raipranav384/EW2_Audio_Amp/Report_ppt/EW-2 Report.docx

EW2 Report:

Pre Amp

Gain

Filter

- Invertin
- Calcualtion

Power-Amp

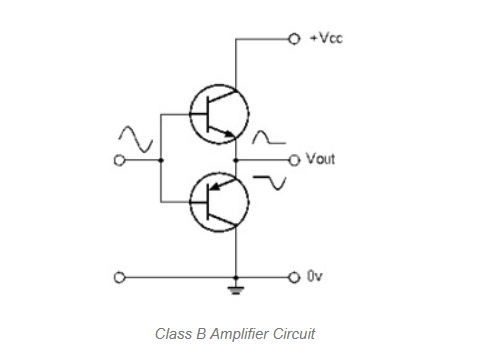
[picture p13: figure]

Mic and Speaker….
