raipranav384/EW2_Audio_Amp/Report_ppt/EW_2_report_audioAmp_2020112022_2020112019.pdf

# Audio Amplifier

EW-2

Rohan Gupta – 2020112022
Pranav Manu – 2020112019
- The goal of audio amplifiers is to reproduce input audio signals at sound-producing output elements, with desired volume and power levels—faithfully, efficiently, and at low distortion.
- Audio frequencies range from about 20 Hz to 20 kHz, So the amplifier must have good frequency response over this range (less when driving a band-limited speaker, such as a woofer or
a tweeter).
- Following are the stages of a general audio Amplifier:

Components Used:

Component Name | Values
1. Resistor | 100K, 120, 33k, 8.6k, 1MEG, 330, 4.7K, 75K, 13K, 10K, 120k
2. Capacitor | 470u, 1u, 4.7u, 100p, 1n
3. BJT’s | BC 547B, BC 557B, Tip 31C, Tip 32 C
4. Opamp | LM 741
5. Mic
6. Input Source | +-13 V

# Mic Stage

- A transducer which converts sound to voltage.
- Microphones produce very small ac signals that have to travel across long wires to the preamplifier; therefore, impedance is vital at this first stage to prevent signal loss


A Simple Mic Circuit

Mic | Pre-amp | Gain | Filter | Power- Amp

# Load

As we can see that this circuit consists of simple components like a resistor and capacitor, here resistor is used to limit current and the capacitor is responsible for amplifier gain which you can connect with this circuit to amplify the signals. This simple condenser mic circuit is to convert the acoustic sound signal into an electric audio signal.

# Pre-Amplifier Stage

- Preamplifier is a type of electronic amplifier. It doesn't have enough power to feed speakers. Rather a preamplifier amplifies weak signals, for example from a microphone, and removes noise for electronic processing or distribution.
- Preamp boosts a low-level signal, making it line level.
- A typical sensor circuit produces an output voltage between nodes A and B (see Fig. 1), where Vc is called the “common-mode” voltage and Vd the “difference-mode” or “differential” voltage. The common-mode voltage is a result of the biasing arrangement used within the sensor
- We don’t require common mode voltage, so we use differential amplifier circuit as pre-amp to amplify differential mode voltage which is the quantity of actual interest.
- The output of differential amplifier is given by:

Vout = AdVid + ACVic

- where Ad is the differential gain, and Ac is the common-mode gain. A good differential amplifier should reject Vic entirely, i.e., it should have Ac = 0. In reality, Ac for a differential amplifier is small but finite, and a figure of merit called the “Common-Mode Rejection Ratio” (CMRR) is used to indicate the effectiveness of the amplifier in rejecting common-mode inputs. The CMRR is defined as

CMRR = |

Ad
Ac

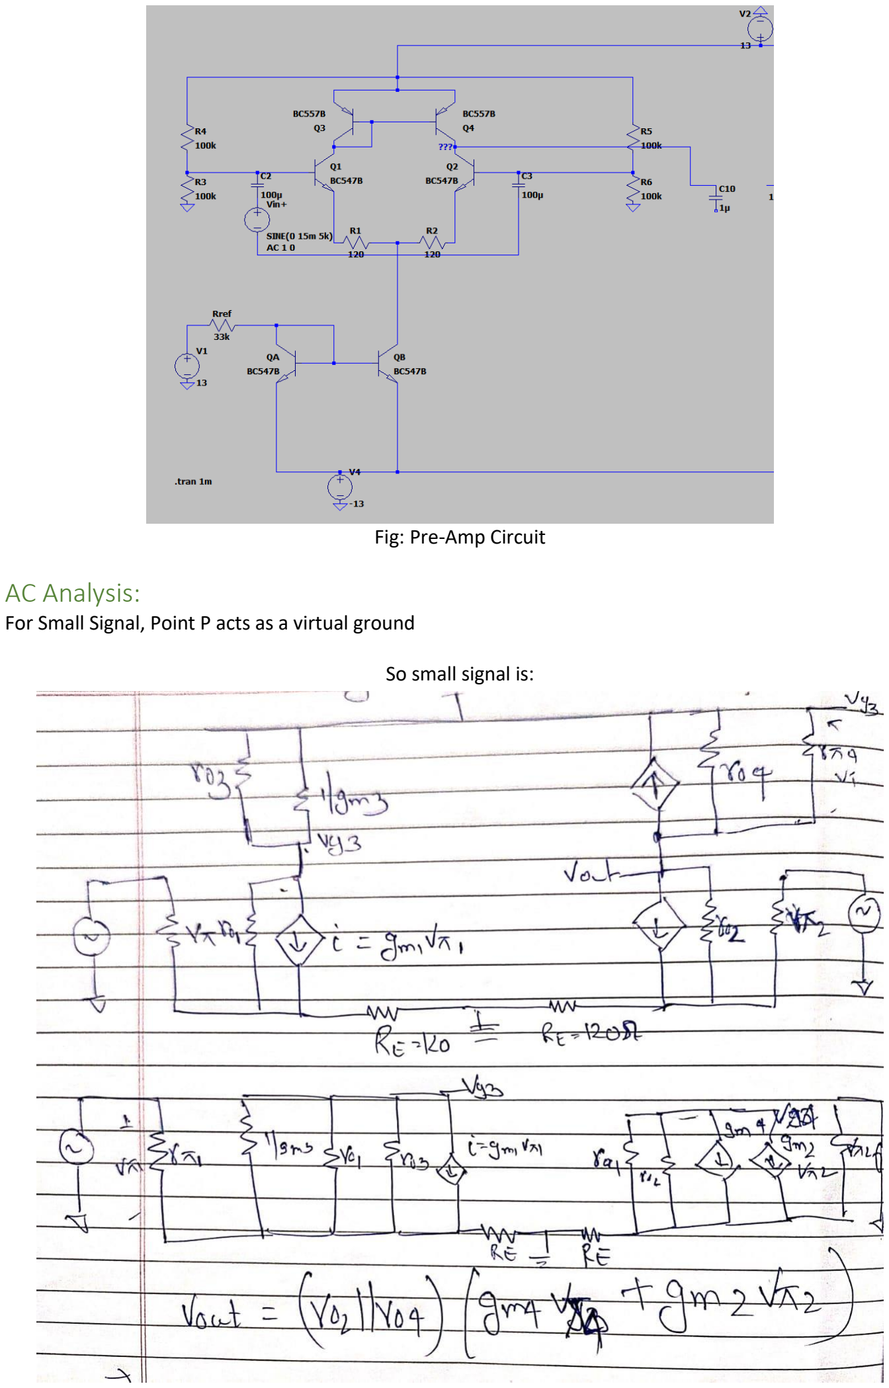
[picture p14: page 3]

Fig: Pre-Amp Circuit

## AC Analysis:

For Small Signal, Point P acts as a virtual ground

So small signal is:

Since the transistors are matched, we can say

Vout = (ro2 ∥ ro4

)(gm4vπ4 + gm2vπ2

)

From Common Emitter- Emitter bias and half circuit we can say:

Vπ =

Vin
(1 + gmRE

)

Since all the Transistors are matched and Vin =

Vid
2

Vout =

r0gmVid
4(1 + gmRE

)

, β = 327, r0 =

Va
IC

, gm =

IC
VT

=

393uA
26mV

= 0.015

Av =

20.1
1
0.015 + 120

= 237. 31

Rout = ro = 20Ω

Ideally, we want common mode gain to be zero but, that is not the case, so we calculate the ration between gain of differential input and differential output to calculate CMRR. The more the CMRR, better is the noise suppression in the differential amplifier.

Ad = 47. 02 dB
Ac = −70 dB,

∴ CMRR = 117.02

Current Mirror is used to bias the circuit.

IC =

26
2 ∗ 33k

= 393uA

Current mirror provides the desired bias current and simultaneously achieves a high CMRR.

## Simulation:

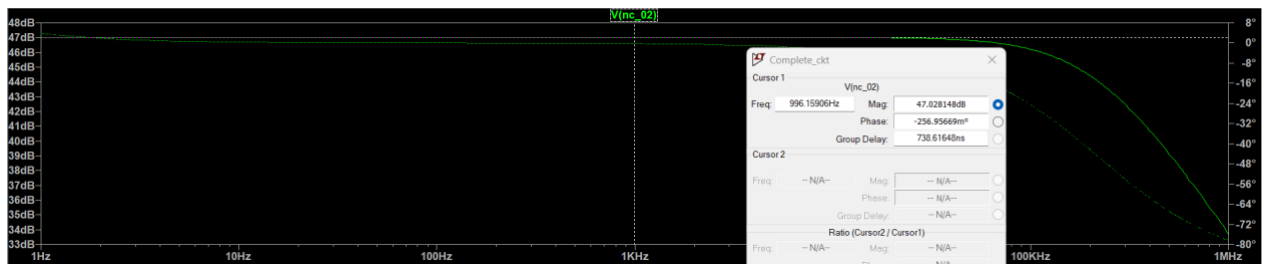
[picture p15: figure]

- The gain in simulation is 47dB, which is close to 223

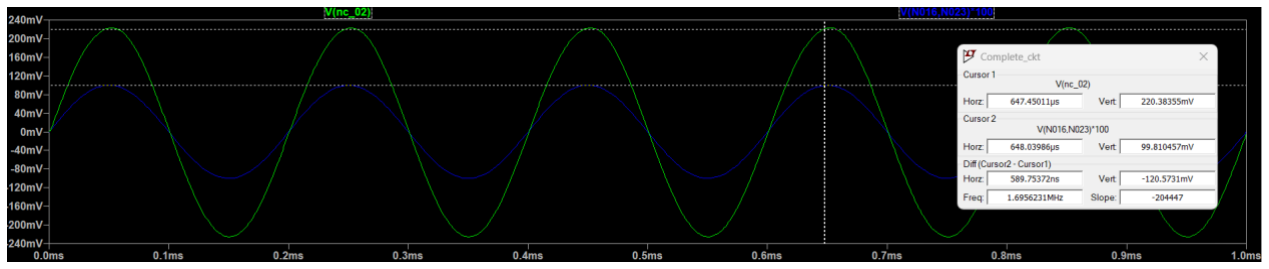
[picture p16: figure]

Gain when rest of the circuit is attached: 39.1

## Summary:

Gain | 231
Rout | 20. 1Ω

# Buffer Stage

The gain obtained in the differential amplifier stage is affected by the stages ahead, because of the changes in current drawn and reactance of further stages. To make the differential amplifier stage independent of the other stages, we can use a buffer stage, also called a Source Follower. The gain of a source follower is ideally equal to 1, and has a high input resistance, and a low output impedance (like a voltage source).

## DC Analysis:


VCC = 13V

VBE = VCC − IC ∗ RE

Assuming IB → 0, VB ≈ VCC and in forward bias of base and emitter, VBE ≈ 0.7V

IC =

VCC − VBE
RE

=

12.3
1000 = 12.3mA

## AC Analysis:

The circuit above is the source follower circuit used. Small signal model of the source follower is (Ignoring) the early effect:

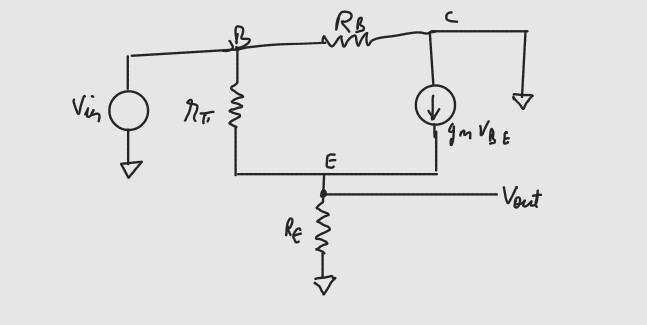
[picture p17: figure]

Gain
Therefore, gain can be derived using KCL at E:

{VBE}
{rπ

}

+ gm ∗ VBE =

Vout
RE

VBE (

1
rπ

+ gm) =

Vout
RE

VBE = Vout − Vin and gm ∗ rπ = β

Av =

RE

(1 + β)
rπ + RE

(1 + β)

Av =

RE
rπ
1 + β

+ RE

≈

RE
rπ
β

+ RE

Here, β = 327, rπ =

β
gm

, gm =

IC
VT

=

12.3mA
26mV

= 0.473

∴ rπ =

327
0.473 ≈ 691Ω

Av =

1000
691
327 + 1000

= 0.998

Av = 0. 998

Input Impedance:
Input impedance can here be similarly calculated, to get: Rin = (rπ + RE

(1 + β))||RC

Where, rπ = 691Ω,RE = 1kΩ, β = 327,gm = 0.473

Rin = 8380.7 Ω

Output Impedance:
Output impedance is calculated using: Rout =

1
gm

||RE

Rout = 2. 11 Ω

## Simulation:

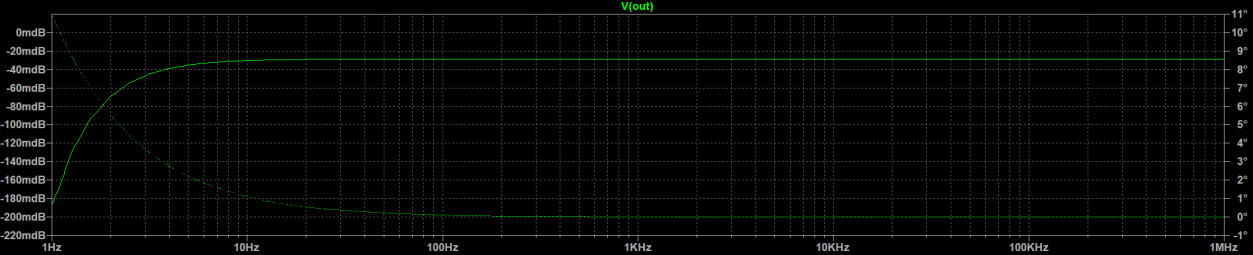
[picture p18: figure]

- The gain in simulation is -20mdB, which is close to 1

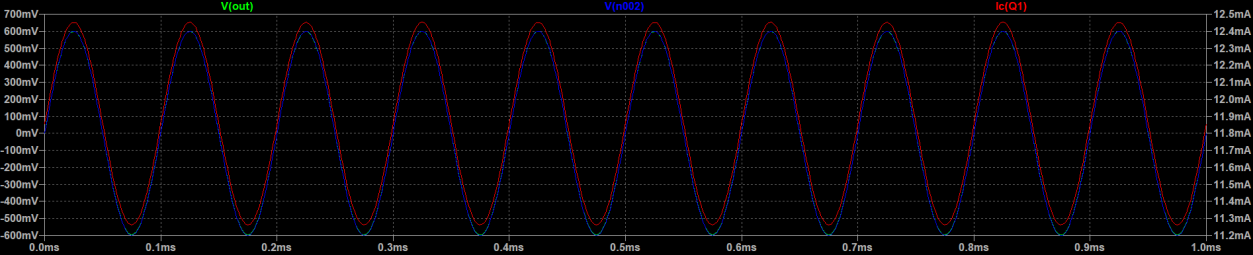
[picture p19: figure]

- The output and input coincide, and the current is centred around 12mA

## Summary

Gain | 0.998
Rin | 8. 3kΩ
Rout | 2. 11Ω

∴We see that the input impedance is high and the output impedance is small and gain is 1, so the previous stage sees this as a voltmeter, and the next stage sees this as a voltage source, and the gain of either side is unaffected.

# Gain Stage

Gain stage here is used to increase the total gain obtained to around 500. For this, we use a CE Amplifier setup, with emitter degeneration and self-biasing. The CE amplifier is simple amplifier circuit that gives voltage gain, with little to no current gain. The input is provided at the Base, and the output is taken from the Collector.

The resistor at the emitter is improves the linearity of the circuit. It also increases the input impedance, which is desirable, as explained in the buffer stage.

Self-Biasing:-

We use self-biasing to bias the CE amplifier, which provides a feed back loop, to maintain the BJT in forward active region. When Vout increases, VBE increases as VB increases, because VB ≈ VC ∵ IB ≈ 0, so IC increases, which reduces Vout = Vcc − ICRC, making a negative feed back loop.

## Circuit Diagram

## DC Analysis:


VBE = VB − ICRE + Vcc
VB ≈ VC = Vcc − ICRC
VBE ≈ 0.7V in forward active region

0.7 = 2 ∗ Vcc − IC

(RE + RC

)

IC =

25.03
12330 = 2.051mA

## AC Analysis:

Small signal model:

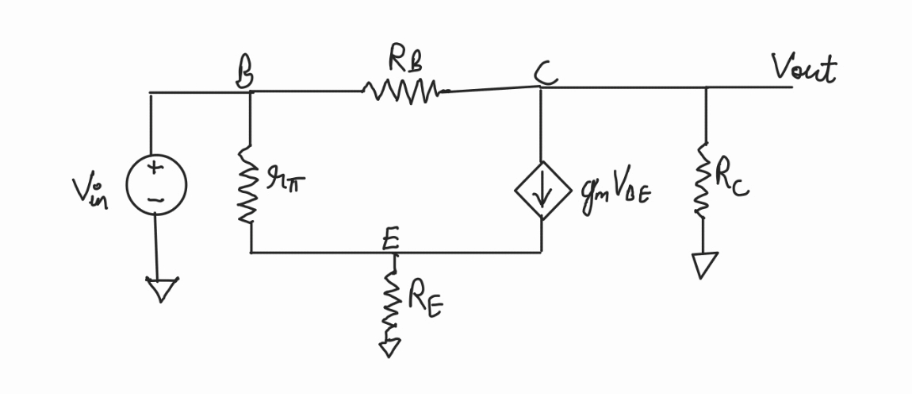
[picture p20: figure]

Gain:
KCL at C:

Vout
RC

+ gmVBE +

Vout − Vin
RB

= 0

RB = 1e6 ⇒

Vout − Vin
RB

≈ 0

VE = I ∗ RE
VE = (gmVBE +

VBE
rπ

) ∗ RE

VBE = Vin − VE

VBE =

Vin
1 + (gm +

1
rπ

) . RE

⇒

Vout

Vin

= Av = −

gmRC
1 + (gm +

1
rπ

) .RE

gm ≫

1
rπ

Av = −

Rc
1
gm

+ RE

Av = −

4700
330 + 2.12 ≈ 14.1

NOTE: After adding the filter, there is a drop in the gain of the circuit, because of the reactance of the filter stage.

Input Impedance:
Input impedance for Common Emitter with emitter degeneration comes to be:

Rin = rπ + (1 + β) ∗ RE

Here, β = 327,RE = 330Ω, rπ = 691Ω

Rin = 691 + (328) ∗ 330
Rin = 108931Ω = 108.9kΩ

Rin = 108. 9kΩ

Output Impedance
If Early effect is neglected, the emitter resistance does not affect the output resistance, and is equal to:

Rout = RC
Rout = 4. 7kΩ

## Simulation:

Transient:

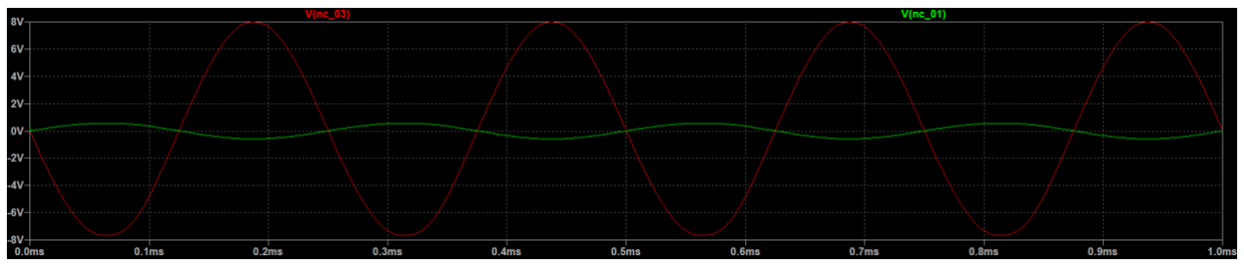
[picture p21: figure]

AC analysis:

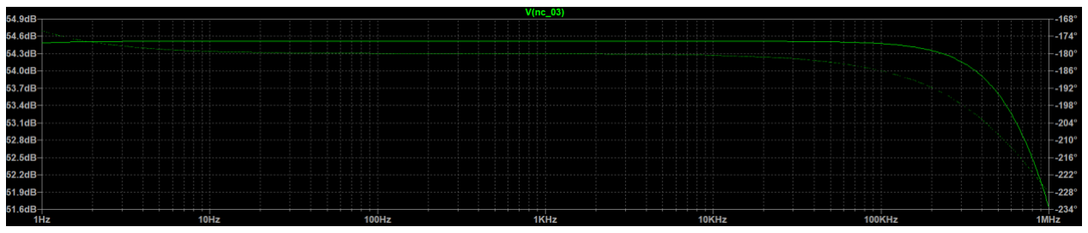
[picture p22: figure]

We observe that the gain is 54.5 dB, of the circuit, up to the gain stage, which is about 530 gain value.

## Summary

Gain | 14.1
Rin | 108. 9kΩ
Rout | 4. 7kΩ

∴We see that the input impedance is high and the output impedance is small and gain is high.

After this stage, we reach the required gain of more than 500, while also not cutting off the frequencies in the range of 20-20kHz.

# Filter Stage:

The filter stage is used to filter out the frequencies that are not audible to human ears, i.e. frequencies below 20Hz and above 20kHz. To this effect, we use an Inverting Band Pass Active Filter, which uses an Op-Amp with a low pass and high pass filters, to make a band pass filters, with lower 3dB cut off at 20Hz and the higher 3 dB cut off at 20kHz. This helps to reduce the wastage of power, which would have been otherwise used to amplify noise in these inaudible frequency ranges.

The reason for using and active filter, is that if we used a passive filter, the band pass frequency would be affected by the resistance of the load, which would start acting like a high pass filter, shifting the cut off region. Using the Op Amp, we make the filter active, whose pass band width is independent of load.

## Circuit:

## Transfer Function:

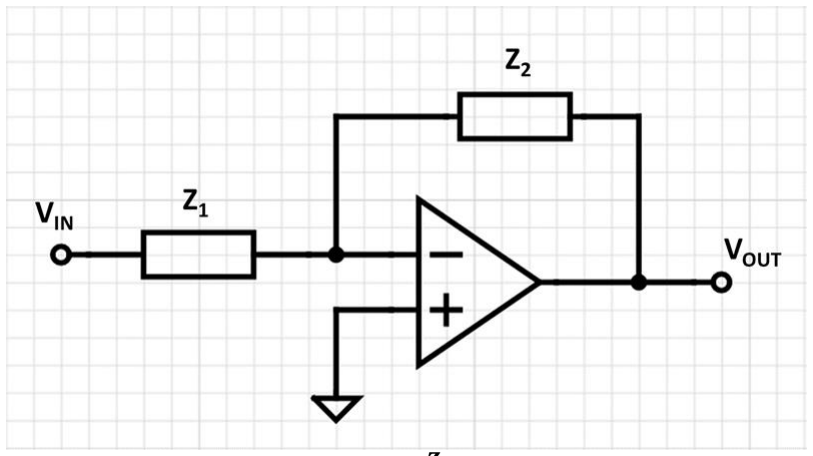
[picture p23: figure]

Av = −

Z2
Z1

Z2 =

R2
jωC2 (R2 +

1
jωC2

)

=

R2
jωR2C2 + 1

Z1 = R1 +

1
jωC1

=

jωR1C1 + 1
jωC1

Av = −

R2 ∗ jωC1
(jωR2C2 + 1) ∗ (jωR1C1 + 1)

R2C2 =

1
ωH

; R1C1 =

1
ωL

Av = −

R2 ∗ jωC1
(

jω
ωH

+ 1) ∗ (

jω
ωL

+ 1)

Av = −

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
+ 1) ∗ (

jω
ωL

+ 1)

|Av

| =

ωR2
ωLR1

1
√(
ω²
ωH

2 + 1) ∗ (

ω²
ωL

2 + 1)

Poles:

P1 = jωL
P2 = jωH

Zeros:

Z1 = 0

## Max Gain:

AvMax = −

R2
R1

= 1.6

- This gain is used to compensate for the loss in gain caused due to attaching the filter.

## Cut-Off Frequency:

ωL =

1
R1C1

⇒ fL =

1
2πR1C1

=

1
2π ∗ 7500 ∗ 0.6e − 6
fL ≈ 20Hz

ωH =

1
R2C2

⇒ fH =

1
2πR2C2

=

1
2π ∗ 13000 ∗ 0.6e − 9

fH ≈ 20kHz

## Simulation:

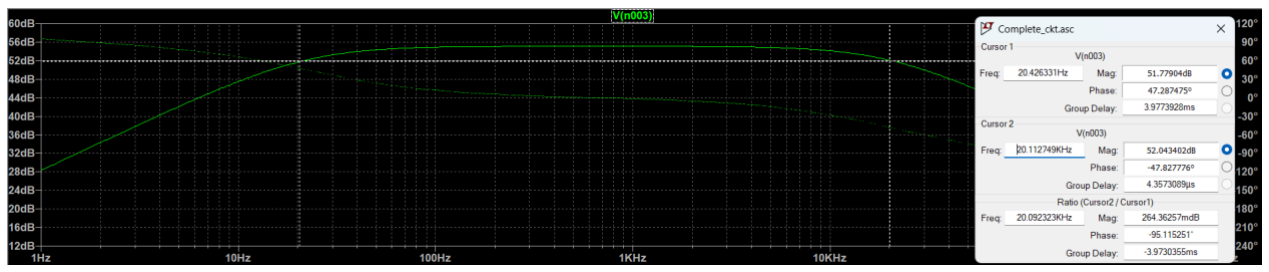
[picture p24: figure]

# Power Stage:

- The power amplifier amplifies the Power of the signal to drive loads of output devices like speakers and headphones.
- Class B amplifier is a type of power amplifier where the active device (transistor) conducts only for one half cycle of the input signal. That means the conduction angle is 180° for a Class B amplifier. Since the active device is switched off for half the input cycle, the active device dissipates less power and hence the efficiency is improved. Theoretical maximum efficiency of Class B power amplifier is 78.5%.

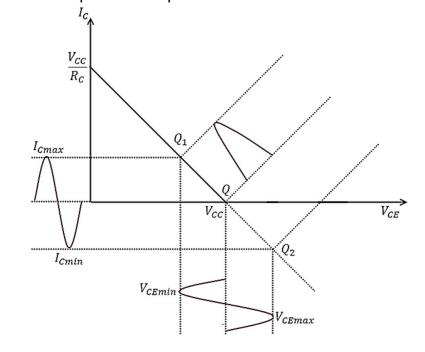
[picture p25: figure]

- To realize a practical Class B amplifier is to use a pair of active devices (transistors) arranged in push-pull mode where one transistor conducts one half cycle, and the other transistor conducts the other half cycle
- The output from both transistors are then combined to get power amplified replica of the input.

Current Gain =

Ic
Ib

= βac ; C. G max = 650

Ib =

Vbb − Vbe
RB

Fig.- Output characteristics Curve

# Final output:

- Vin = sine wave of 15mV @ 5kHz Load = 10 ohms

Pavg =

6.3
2

= 3. 15 W

Av =

Voutmax

Vinmax

=

7. 7
0. 015 = 513

AC Analysis: -3db cut-off at: 20.1KHz and 20.1Hz

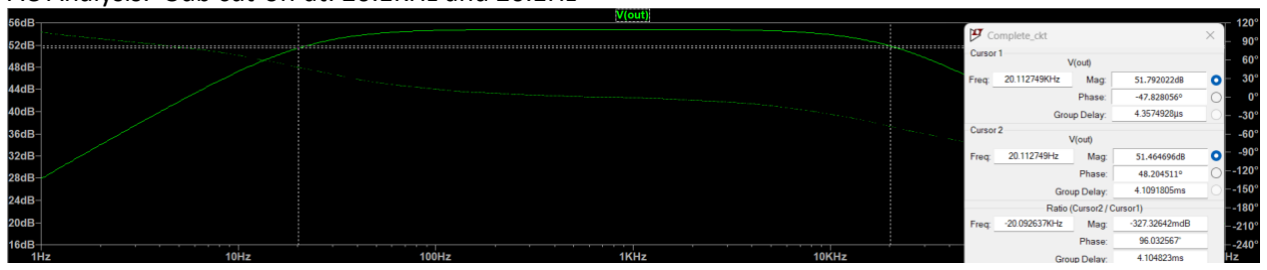
[picture p26: figure]

# Hardware output:

- Vin = sine wave of 10mVpp @ 1kHz Load = 10 ohms

Pavg =

8. 6 ∗ 0. 5
2

= 2. 15 W

Av =

Voutmax

Vinmax

=

8. 6
0. 01 = 860

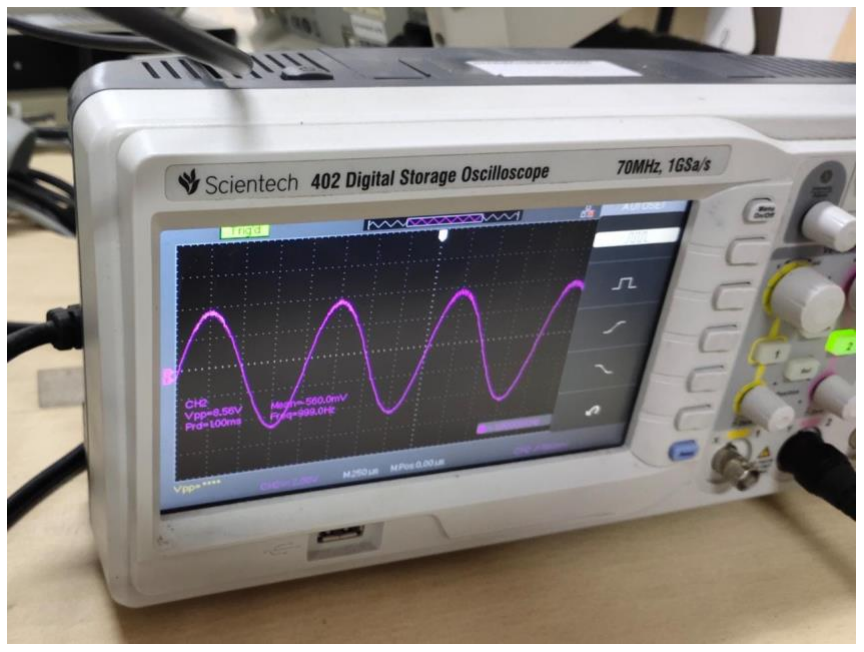
[picture p27: figure]

Final Output on hardware

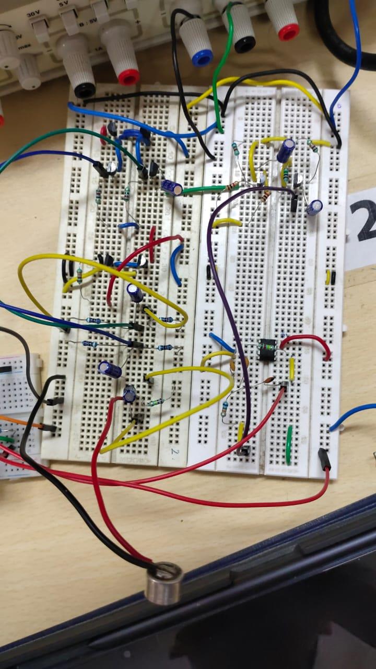
[picture p28: figure]

## Final Hardware

# Conclusion

We have an Audio Amplifier, which can take input from a microphone, and drive a speaker to amplify the audio given in to the microphone. The circuit rejects noise and inaudible frequencies, to provide a high efficiency amplifier circuit.
