raipranav384/EW2_Audio_Amp/circuit/BJT_Diff_amp_Gain_DE_4_diff_in.asc

C1: cap; 100µ
C2: cap; 100µ
C3: cap; 100µ
C4: cap; 1µ
C5: cap; 100µ
C6: cap; 100µ
C7: cap; 10µ
C9: cap; 0.001µ
Q1: npn; BC547B
Q2: npn; BC547B
Q3: pnp; BC557B
Q4: pnp; BC557B
Q5: npn; BC547B
Q6: npn; BC547B
QA: npn; BC547B
QB: npn; BC547B
R1: res; 150
R2: res; 150
R3: res; 100k
R4: res; 100k
R5: res; 100k
R6: res; 100k
R7: res; 3.5k
R8: res; 1k
R9: res; 1Meg
R11: res; 1Meg
R12: res; 3.7k
R13: res; 1Meg
R15: res; 1k
R16: res; 7.5k
R17: res; 7.5k
Rref: res; 2.2k
U1: OP07
V1: voltage; 12
V2: voltage; 12
V3: voltage; 12
V4: voltage; -12
V5: voltage; 12
V6: voltage; -12
V7: voltage; -12
Vin1: voltage; SINE(0 -15m 10k); AC 1 180
Vin+: voltage; SINE(0 15m 10k); AC 1 0
Named nets: 0, OUT
.tran 0.1m
;ac dec 10 1 100Meg
;tran 0.1m
