raipranav384/EW2_Audio_Amp/circuit/BJT_Diff_amp_Gain_DE_4_diff_in_negIn_Buffer_2.asc

C1: cap; 100µ
C2: cap; 100µ
C3: cap; 100µ
C4: cap; 1µ
C5: cap; 100µ
C7: cap; 4.7µ
C8: cap; 1µ
C9: cap; 0.01µ
C10: cap; 1µ
Q1: npn; BC547B
Q2: npn; BC547B
Q3: pnp; BC557B
Q4: pnp; BC557B
Q5: npn; BC547B
Q7: npn; BC547B
QA: npn; BC547B
QB: npn; BC547B
R1: res; 0
R2: res; 0
R3: res; 100k
R4: res; 100k
R5: res; 100k
R6: res; 100k
R7: res; 4.6k
R9: res; 1Meg
R11: res; 8.6k
R15: res; 330
R16: res; 1k
R17: res; 2.7k
R18: res; 1k
Rref: res; 110k
U1: OP07
V1: voltage; 13
V2: voltage; 13
V4: voltage; -13
Vin+: voltage; SINE(0 15m 20k); AC 1 0
Named nets: 0, OUT
;tran 1m
.ac dec 10 1 1Meg
.tran 1m
