raipranav384/EW2_Audio_Amp/circuit/Complete_ckt.asc

C1: cap; 100µ
C2: cap; 100µ
C3: cap; 100µ
C4: cap; 0.06µ
C6: cap; 1µ
C7: cap; 470µ
C8: cap; 1µ
C9: cap; 0.1n
C11: cap; 1µ
C12: cap; 470µ
C13: cap; 470µ
C14: cap; 1µ
Q1: npn; BC547B
Q2: npn; BC547B
Q3: pnp; BC557B
Q4: pnp; BC557B
Q5: npn; BC547B
Q6: npn; BC547C
Q7: npn; BC547B
Q8: pnp; BC557B
QA: npn; BC547B
QB: npn; BC547B
R1: res; 220
R2: res; 220
R3: res; 100k
R4: res; 100k
R5: res; 100k
R6: res; 100k
R7: res; 12k
R8: res; 10
R9: res; 1Meg
R10: res; 10k
R11: res; 8.6k
R12: res; 10k
R13: res; 10k
R14: res; 10k
R15: res; 330
R16: res; 75k
R17: res; 120k
R18: res; 1k
Rref: res; 27k
U1: OP07
V1: voltage; 13
V2: voltage; 13
V3: voltage; 13V
V4: voltage; -13
Vin+: voltage; SINE(0 5m 4k); AC 1 0
Named nets: 0, Pre-amp_Out, Mic, Power-amp_Out
.tran 10m
;ac dec 10 1 1Meg
