raipranav384/EW2_Audio_Amp/circuit/Draft4.asc

Q1: npn; BC547B
R2: res; 10
V1: voltage; 10
V2: voltage; 5
Named nets: 0
.dc V1 -100 100 0.001
