raipranav384/EW2_Audio_Amp/circuit/final_class_A.asc

C1: cap; 470µ
Q1: pnp; BC557B
Q2: npn; BC547B
Q3: npn; BC547B
R2: res; 1k
R5: res; 10
V1: voltage; 15
V2: voltage; SINE(0 10 10K); AC 1
V3: voltage; 15
Named nets: 0, OUT
;dc V2 -40 40 0.1
;ac dec 100 1 100MEG
.tran 0 2m 1m
;step param R 1 1050 10
