raipranav384/EW2_Audio_Amp/circuit/last_try.asc

C1: cap; 100µ
C2: cap; 100µ
C3: cap; 100µ
C4: cap; 0.01µ
C5: cap; 100µ
C7: cap; 0.5µ
C8: cap; 1µ
C9: cap; 0.006µ
C10: cap; 1µ
Q1: npn; BC547B
Q2: npn; BC547B
Q3: pnp; BC557B
Q4: pnp; BC557B
Q5: npn; BC547B
Q7: npn; BC547B
QA: npn; BC547B
QB: npn; BC547B
R1: res; 220
R2: res; 220
R3: res; 100k
R4: res; 100k
R5: res; 100k
R6: res; 100k
R7: res; 6.8k
R8: res; 120
R9: res; 1Meg
R10: res; 100k
R11: res; 8.6k
R12: res; 12k
R13: res; 62k
R15: res; 330
R16: res; 330
R18: res; 1k
Rref: res; 27k
U1: OP07
V1: voltage; 13
V2: voltage; 13
V4: voltage; -13
Vin+: voltage; SINE(0 15m 1k); AC 1 0
Named nets: 0, V+, V-, out
;tran 1m
.ac dec 10 1 1Meg
;tran 0 1.4m 1m
;ac dec 100 1 100k
