raipranav384/EW2_Audio_Amp/circuit/filter_multi_feedback.asc

C1: cap; 100µ
C2: cap; 100µ
C3: cap; 100µ
C4: cap; 1.5µ
C5: cap; 100µ
C6: cap; 1n
C7: cap; 1.5µ
C8: cap; 1µ
C9: cap; 1.5µ
C10: cap; 1µ
C11: cap; 1.5µ
Q1: npn; BC547B
Q2: npn; BC547B
Q3: pnp; BC557B
Q4: pnp; BC557B
Q5: npn; BC547B
Q7: npn; BC547B
QA: npn; BC547B
QB: npn; BC547B
R1: res; 220
R2: res; 220
R3: res; 100k
R4: res; 100k
R5: res; 100k
R6: res; 100k
R7: res; 6.8k
R9: res; 1Meg
R10: res; 24k
R11: res; 8.6k
R12: res; 1.2k
R14: res; 500
R15: res; 330
R18: res; 1k
Rref: res; 27k
U1: OP07
V1: voltage; 13
V2: voltage; 13
V4: voltage; -13
Vin+: voltage; SINE(0 15m 2k); AC 1 0
Named nets: 0, out, V-, V+
;tran 1m
;ac dec 10 1 1Meg
;tran 1m
.ac dec 100 1 100k
