raipranav384/EW2_Audio_Amp/circuit/salle_key_filter.asc

C1: cap; 0.01µ
C2: cap; 100n
C3: cap; 100n
R1: res; 8k
R2: res; 8k
R3: res; 6k
R4: res; 10k
R5: res; 750
U1: OP07
V1: voltage; SINE(0 10 10k); AC 1
V3: voltage; -13
V4: voltage; 13
Named nets: out, 0, V+, V-
;tran 0.1m
.ac dec 100 1 100MEG
