raipranav384/EW2_Audio_Amp/circuit/ClassA_amplifier.asc

C1: cap; 10µ
C2: cap; 10µ
Q1: npn; BC547B
R1: res; 5k
R2: res; 300
R3: res; 3.3K
R4: res; 10K
R5: res; 50
V1: voltage; 12
V2: voltage; SINE(0 10 10k)
V3: voltage; 12
Named nets: 0, OUT
.tran 1m
