raipranav384/EW2_Audio_Amp/circuit/Draft2.asc

C1: cap; 7.5µ
C2: cap; 0.001µ
R1: res; 1k
R2: res; 7.5k
U1: OP07
V1: voltage; 15
Vin1: voltage; SINE(0 10m 20k); AC 1 0
Named nets: 0, OUT
