raipranav384/EW2_Audio_Amp/circuit/filter.asc

C1: cap; 1µ
C2: cap; 0.001µ
R1: res; 7.5k
R2: res; 7.5k
U1: OP07
V1: voltage; 12
V2: voltage; -12
Vin1: voltage; SINE(0 10 20k); AC 1 0
Named nets: OUT, 0
.ac dec 1000 1 1MEG
;tran 0.5m
