raipranav384/EW2_Audio_Amp/circuit/made by rohan.asc

C1: cap; 1µ
C2: cap; 1µ
C3: cap; 100µ
C4: cap; 4.7µ
C5: cap; 1µ
C6: cap; 100µ
C7: cap; 0.001µ
C8: cap; 100µ
Q1: npn; BC547B
Q2: npn; BC547B
Q3: pnp; BC557B
Q4: pnp; BC557B
Q5: npn; BC547B
Q6: npn; BC547B
QA: npn; BC547B
QB: npn; BC547B
R1: res; 150
R2: res; 150
R3: res; 100k
R4: res; 100k
R5: res; 100k
R6: res; 100k
R7: res; 3.3k
R8: res; 1k
R9: res; 1Meg
R10: res; 7.5k
R11: res; 1Meg
R12: res; 3.3k
R13: res; 1Meg
R14: res; 7.5k
R15: res; 1k
R16: res; 1Meg
R17: res; 1Meg
Rref: res; 1k
U1: OP07
V1: voltage; 15
V2: voltage; 15
V3: voltage; 15
V4: voltage; 12
V5: voltage; -12
Vin1: voltage; SINE(0 15m 5k); AC 1 0
Vin2: voltage; SINE(0 -15m 5k); AC 1 0
Named nets: 0, OUT
.tran 2m
;ac dec 1000 1 1MEG
;tran 0.5m
