raipranav384/EW2_Audio_Amp/circuit/BJT_Diff_amp_Gain_DE_4_diff_in_negIn_Buffer.asc

C1: cap; 100µ
C2: cap; 100µ
C3: cap; 100µ
C4: cap; 1µ
C5: cap; 100µ
C6: cap; 4.7µ
C7: cap; 4.7µ
C8: cap; 1µ
C9: cap; 0.001µ
C10: cap; 1µ
C13: cap; 1µ
Q1: npn; BC547B
Q2: npn; BC547B
Q3: pnp; BC557B
Q4: pnp; BC557B
Q5: npn; BC547B
Q6: npn; BC547B
Q7: npn; BC547B
QA: npn; BC547B
QB: npn; BC547B
R1: res; 0
R2: res; 0
R3: res; 100k
R4: res; 100k
R5: res; 100k
R6: res; 100k
R7: res; 1k
R8: res; 330
R9: res; 1Meg
R11: res; 8.6k
R12: res; 1.8k
R13: res; 1Meg
R15: res; 330
R16: res; 7.5k
R17: res; 7.5k
R18: res; 1k
Rref: res; 110k
U1: OP07
V1: voltage; 13
V2: voltage; 13
V4: voltage; -13
Vin+: voltage; SINE(0 15m 10k); AC 1 0
Named nets: 0, OUT
.tran 1m
;ac dec 10 1 1Meg
;tran 0.1m
