raipranav384/EW2_Audio_Amp/circuit/BJT_Diff_amp_Gain_DE_4_diff_in_negIn_Buffer_3.asc

C1: cap; 100µ
C2: cap; 100µ
C3: cap; 100µ
C4: cap; 1µ
C5: cap; 100µ
C6: cap; 1µ
C7: cap; 4.7µ
C8: cap; 1µ
C10: cap; 1µ
C13: cap; 1µ
Q1: npn; BC547B
Q2: npn; BC547B
Q3: pnp; BC557B
Q4: pnp; BC557B
Q5: npn; BC547B
Q7: npn; BC547B
QA: npn; BC547B
QB: npn; BC547B
R1: res; 0
R2: res; 0
R3: res; 100k
R4: res; 100k
R5: res; 100k
R6: res; 100k
R7: res; 12k
R8: res; 20k
R9: res; 1Meg
R10: res; 2k
R11: res; 7.76k
R12: res; 1k
R15: res; 1k
R16: res; 10k
R17: res; 10k
R18: res; 1k
Rref: res; 110k
U2: OP07
V1: voltage; 13
V2: voltage; 13
V4: voltage; -13
Vin+: voltage; SINE(0 15m 20k); AC 1 0
Named nets: 0, OUT
.tran 1m
;ac dec 10 1 1Meg
;tran 0.1m
.param R=10K C=1u
;step param R 1k 10k 1k
