raipranav384/EW2_Audio_Amp/circuit/BJT_Diff_amp_Gain_DE_2_feedback.asc

C1: cap; 100µ
C2: cap; 100µ
C4: cap; 100µ
C5: cap; 100µ
C6: cap; 100µ
Q1: npn; BC547B
Q2: npn; BC547B
Q3: pnp; BC557B
Q4: pnp; BC557B
Q5: npn; BC547B
Q6: npn; BC547B
QA: npn; BC547B
QB: npn; BC547B
R1: res; 0
R2: res; 0
R3: res; 100k
R4: res; 100k
R5: res; 100k
R6: res; 100k
R7: res; 5.6k
R8: res; 1k
R9: res; 1Meg
R10: res; 10k
R11: res; 1Meg
R12: res; 5.6k
R13: res; 1Meg
R14: res; 1k
R15: res; 1k
Rref: res; 1k
V1: voltage; 30
V2: voltage; 30
V3: voltage; 30
Vin+: voltage; SINE(0 20m 20k); AC 1 0
Named nets: 0, OUT
.tran 1m
;ac dec 0.1m 1 100Meg
