raipranav384/EW2_Audio_Amp/circuit/BJT_Diff_amp_Gain_DE_3_negIn.asc

C1: cap; 100µ
C2: cap; 100µ
C3: cap; 100µ
C4: cap; 100µ
C5: cap; 100µ
C6: cap; 100µ
Q1: npn; BC547B
Q2: npn; BC547B
Q3: pnp; BC557B
Q4: pnp; BC557B
Q5: npn; BC547B
Q6: npn; BC547B
QA: npn; BC547B
QB: npn; BC547B
R1: res; 1k
R2: res; 1k
R7: res; 3.3k
R8: res; 1k
R9: res; 1Meg
R12: res; 3.8k
R13: res; 1Meg
R15: res; 1k
Rref: res; 1k
V1: voltage; 10
V2: voltage; 10
V3: voltage; 10
V4: voltage; -10
V5: voltage; -10
Vin1: voltage; SINE(0 -25m 20k); AC 1 0
Vin+: voltage; SINE(0 25m 20k); AC 1 0
Named nets: 0, OUT
;tran 0.1m
.ac dec 0.1m 1 100Meg
