raipranav384/EW2_Audio_Amp/circuit/Filter1.asc

C1: cap; 1µ
C2: cap; 0.001µ
R1: res; 7.5k
R2: res; 7.5k
U1: OP07
V1: voltage; SINE(0 1 10k); AC 1
V2: voltage; 15
V3: voltage; -15
Named nets: 0, OUT
.ac dec 100 1 1Meg
;tran 0.1m
