raipranav384/EW2_Audio_Amp/circuit/Filter2.asc

C1: cap; 1µ
C2: cap; 0.001µ
R1: res; 7.5k
R2: res; 7.5k
V2: voltage; SINE(0 8 10); AC 1
Named nets: 0, OUT
.ac dec 10 1 1Meg
;tran 0.1m
