raipranav384/EW2_Audio_Amp/circuit/BJT_Diff_amp_activeLoad5.asc

C1: cap; 100µ
C2: cap; 100µ
C3: cap; 100µ
Q1: npn; BC547B
Q2: npn; BC547B
Q3: pnp; BC557B
Q4: pnp; BC557B
QA: npn; BC547B
QB: npn; BC547B
R1: res; 30
R2: res; 30
R3: res; 100k
R4: res; 100k
R5: res; 100k
R6: res; 100k
Rref: res; 100
V1: voltage; 15
V2: voltage; 15
Vin+: voltage; SINE(0 10m 20k); AC 1 0
Vin-: voltage; SINE(0 -10m 20k); AC 1 180
Named nets: 0, Out+
.tran 0.1m
;ac dec 500 1 100Meg
