raipranav384/EW2_Audio_Amp/circuit/CE_gain_stage.asc

C1: cap; 100µ
C2: cap; 100µ
Q1: npn; BC547B
R1: res; 1000k
R2: res; 8k
R3: res; 1k
R4: res; 120k
V1: voltage; 15
V2: voltage; SINE(0 800m 20k); AC 1 0
Named nets: 0, OUT
.tran 1m
