raipranav384/EW2_Audio_Amp/circuit/BJT_Diff_amp_activeLoad2.asc

C1: cap; 100µ
Q1: npn; BC547B
Q2: npn; BC547B
Q3: pnp; BC557B
Q4: pnp; BC557B
QA: npn; BC547B
QB: npn; BC547B
R1: res; 1k
R2: res; 1k
Rref: res; 1k
V1: voltage; 5
V2: voltage; 10
Vin+: voltage; SINE(5 10m 50); AC 1 0
Vin-: voltage; SINE(5 -10m 50); AC 1 0
Named nets: 0, Out+
;.tran 500m
.ac dec 500 1 100Meg
