raipranav384/EW2_Audio_Amp/circuit/BJT_Diff_amp_activeLoad.asc

Q1: npn
Q2: npn
Q3: pnp
Q4: pnp
QA: npn
QB: npn
R1: res
R2: res
RA: res
RB: res
Rref: res
V1: voltage
V2: voltage
Vin+: voltage
Vin-: voltage
Named nets: 0, Out+
