raipranav384/EW2_Audio_Amp/circuit/BJT_Diff_amp.asc

Q1: npn
Q2: npn
QA: npn
QB: npn
R1: res
R2: res
R6: res
R7: res
RA: res
RB: res
Rref: res
V1: voltage
V2: voltage
Vin+: voltage
Vin-: voltage
Named nets: 0, Out+, Out-
