raipranav384/EW2_Audio_Amp/(commit log)

2023-01-21 Added gain stage
2023-02-12 ckt with buffer and filter
2023-02-13 filter done
